ryood/LME49600_HPA_V2/P1130260.jpg

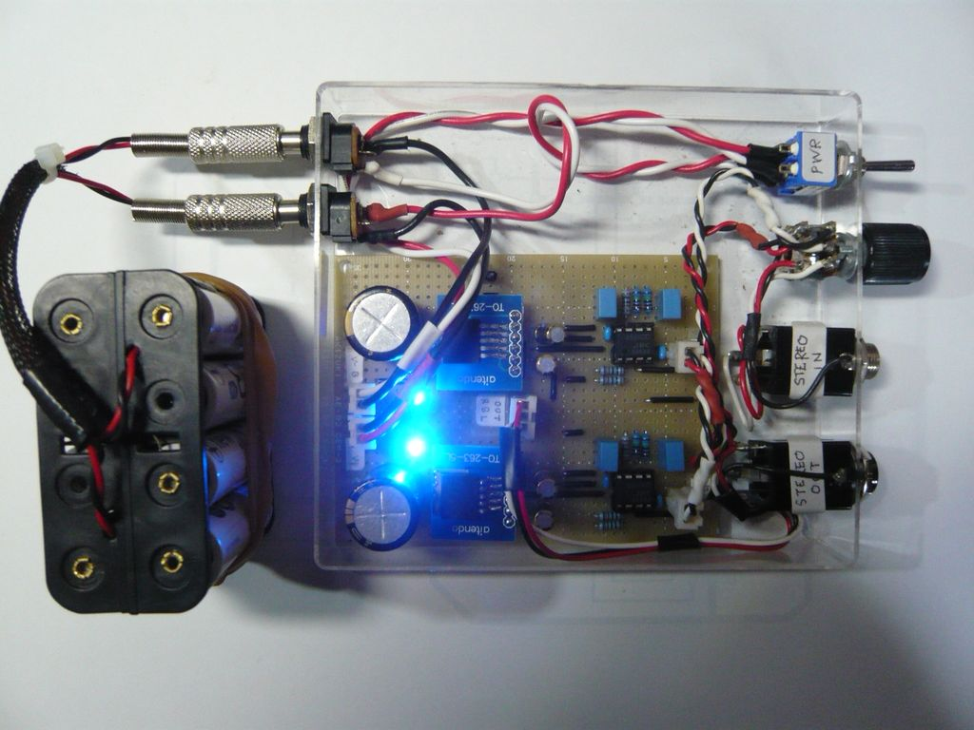
P1130260.jpg
