ryood/LME49600_HPA_V2/P1130270.jpg

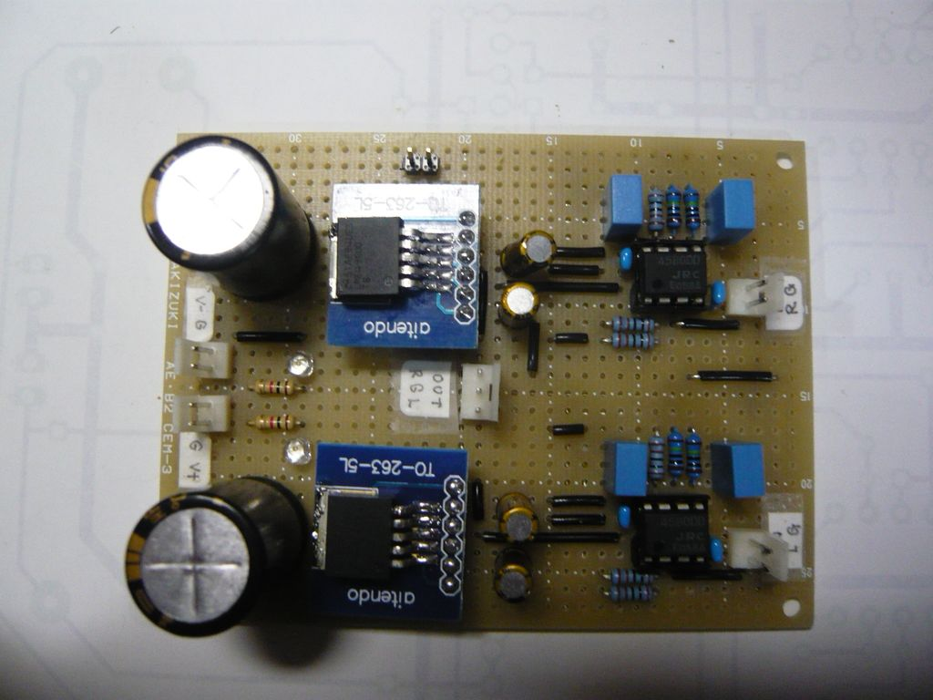
P1130270.jpg
