ryood/LME49600_HPA_V2/+-9V_PSU/7809.png

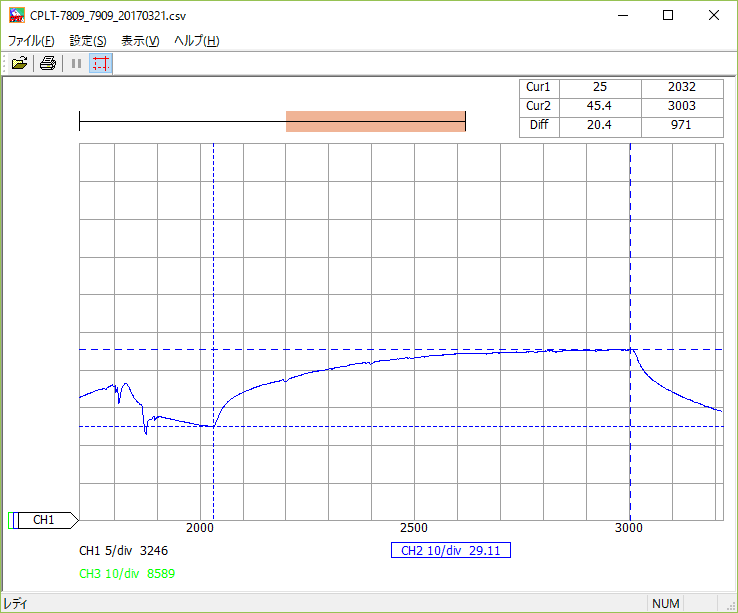
+-9V_PSU/7809.png
