ryood/LME49600_HPA_V2/+-9V_PSU/case/±9V PSU ケース内配線_ブレッドボード.png

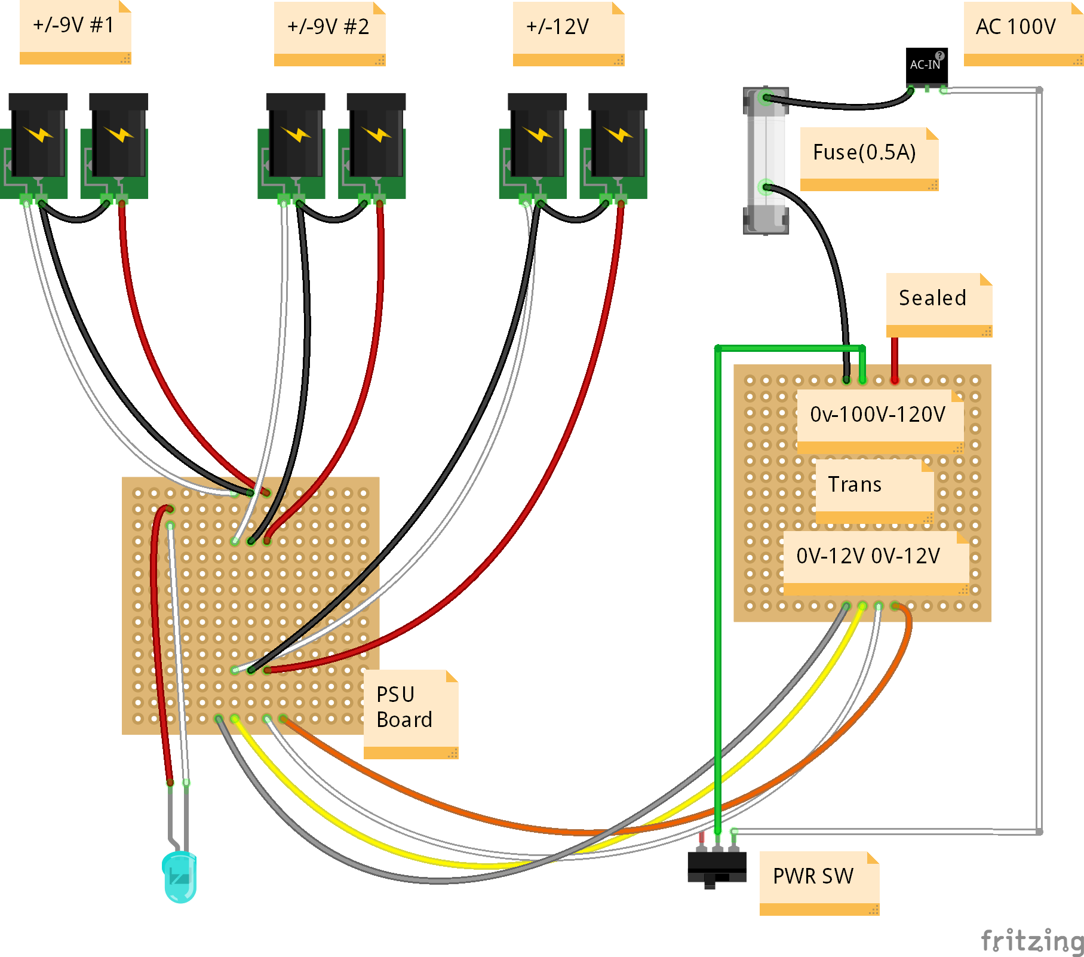
+-9V_PSU/case/±9V PSU ケース内配線_ブレッドボード.png
