ryood/LME49600_HPA_V2/+-9V_PSU/eagle/+-9V_PSU_brd.png

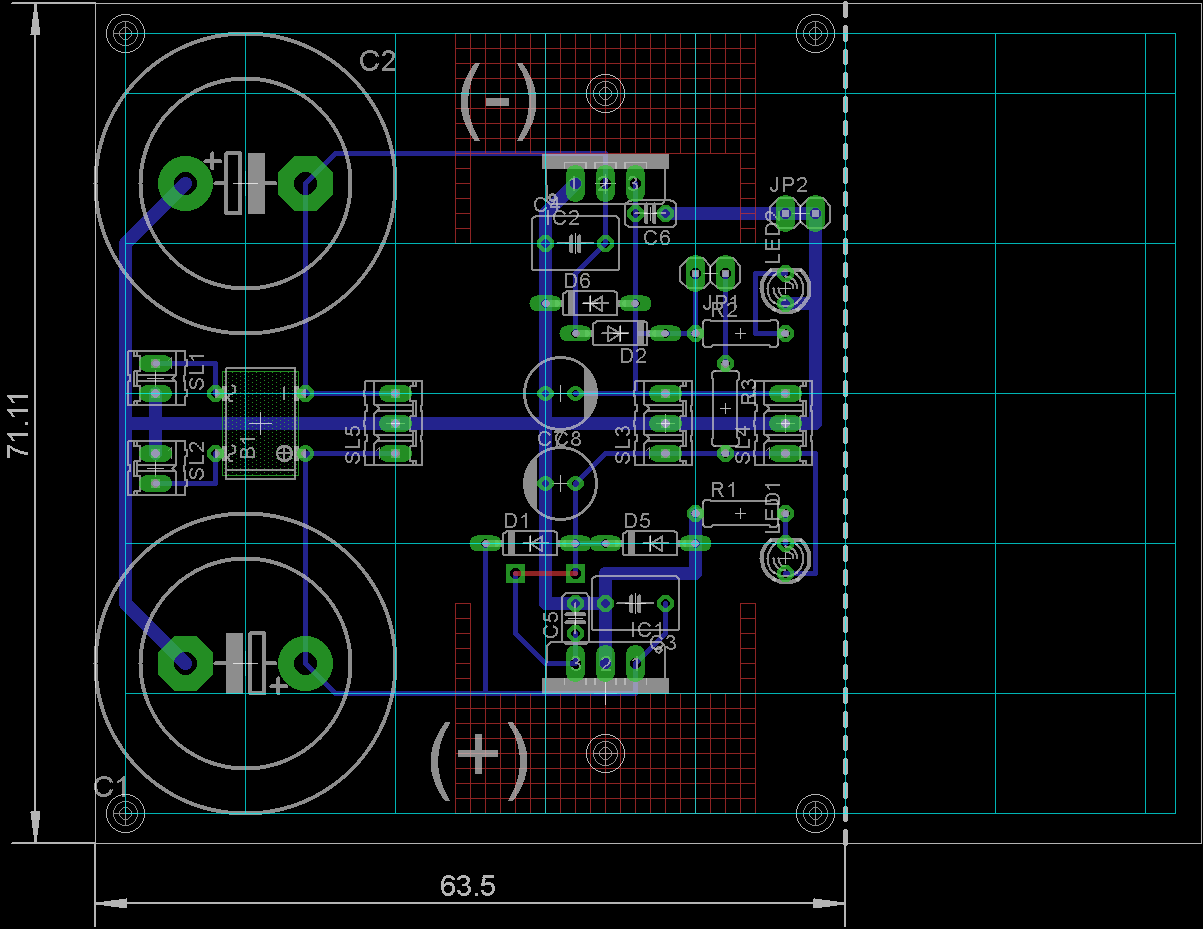
+-9V_PSU/eagle/+-9V_PSU_brd.png
