ryood/LME49600_HPA_V2/+-9V_PSU/fritzing/±9V_PSU_ブレッドボード.png

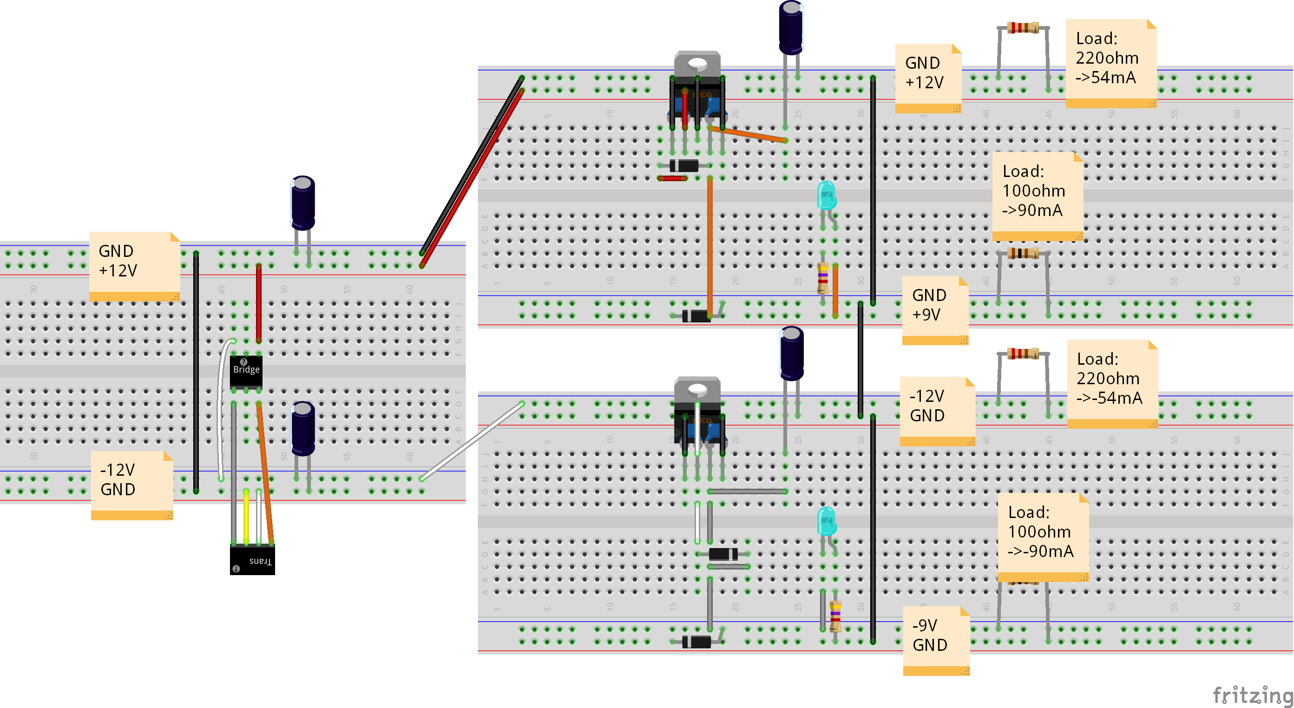
+-9V_PSU/fritzing/±9V_PSU_ブレッドボード.png
