ryood/LME49600_HPA_V2/+-9V_PSU/LTSpice/TroidalTrans_sim.png

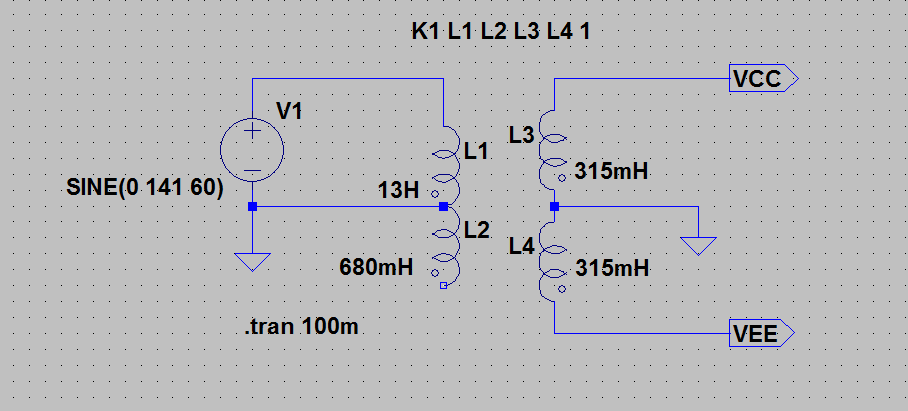
+-9V_PSU/LTSpice/TroidalTrans_sim.png
