ryood/LME49600_HPA_V2/eagle/LME49600 HPA_brd.png

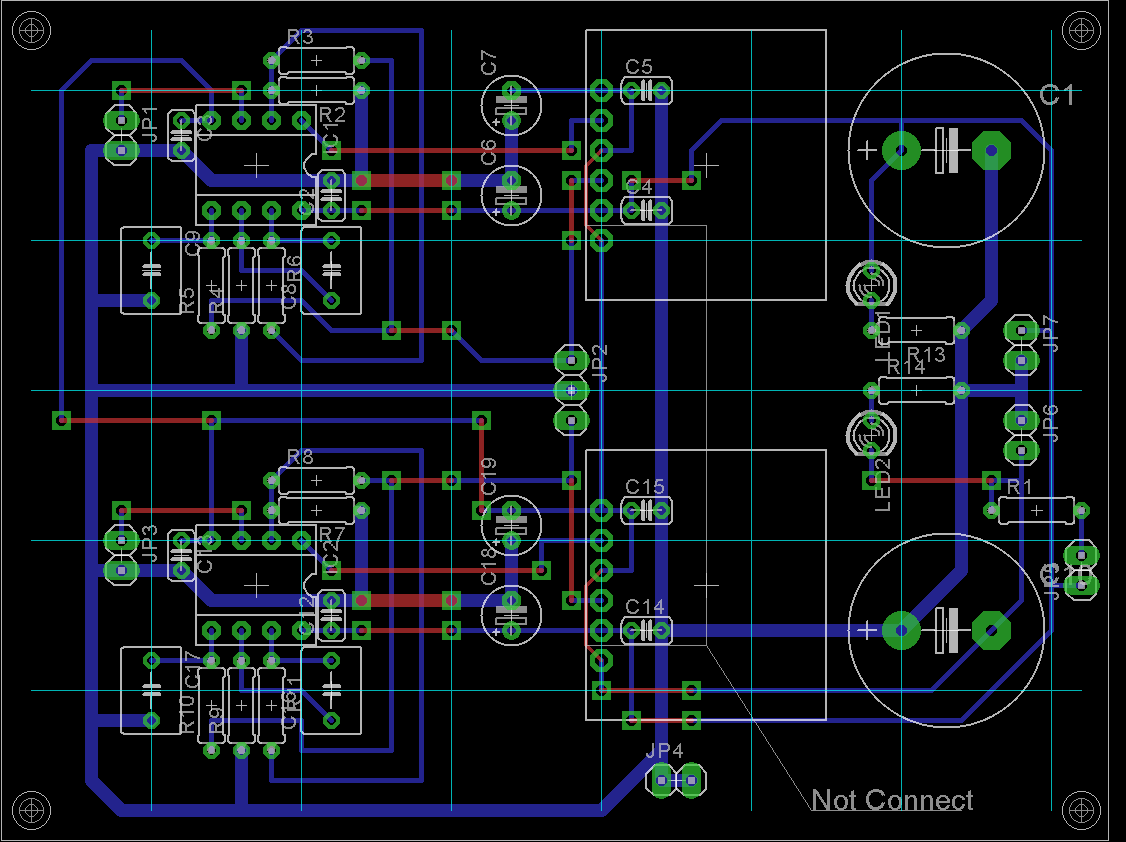
eagle/LME49600 HPA_brd.png
