ryood/LME49600_HPA_V2/eagle/LME49600 HPA_sch.png

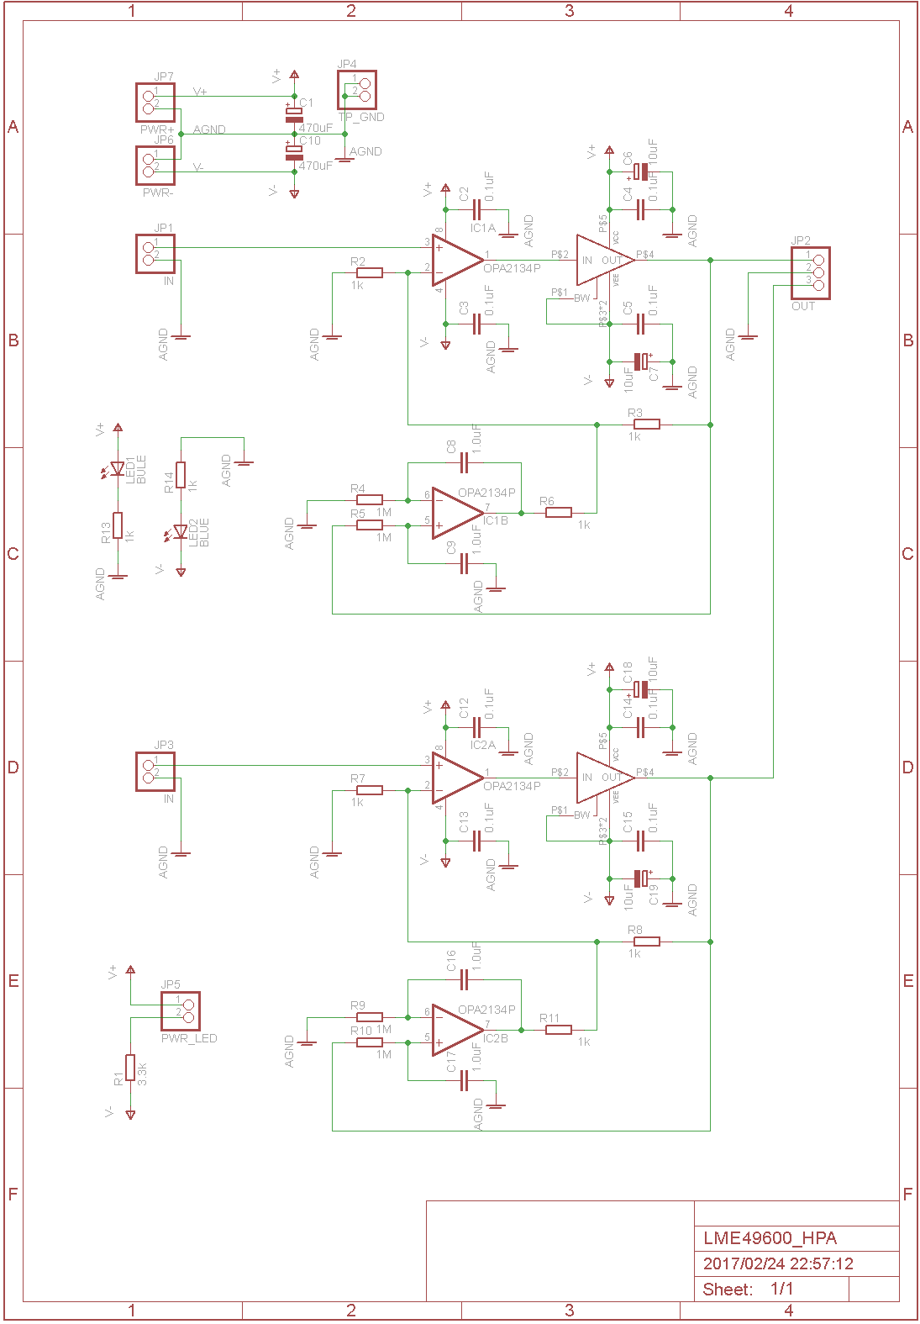
eagle/LME49600 HPA_sch.png
