ryood/LME49600_HPA_V2/fritzing/LME49600 HPA AC Coupling_ブレッドボード.png

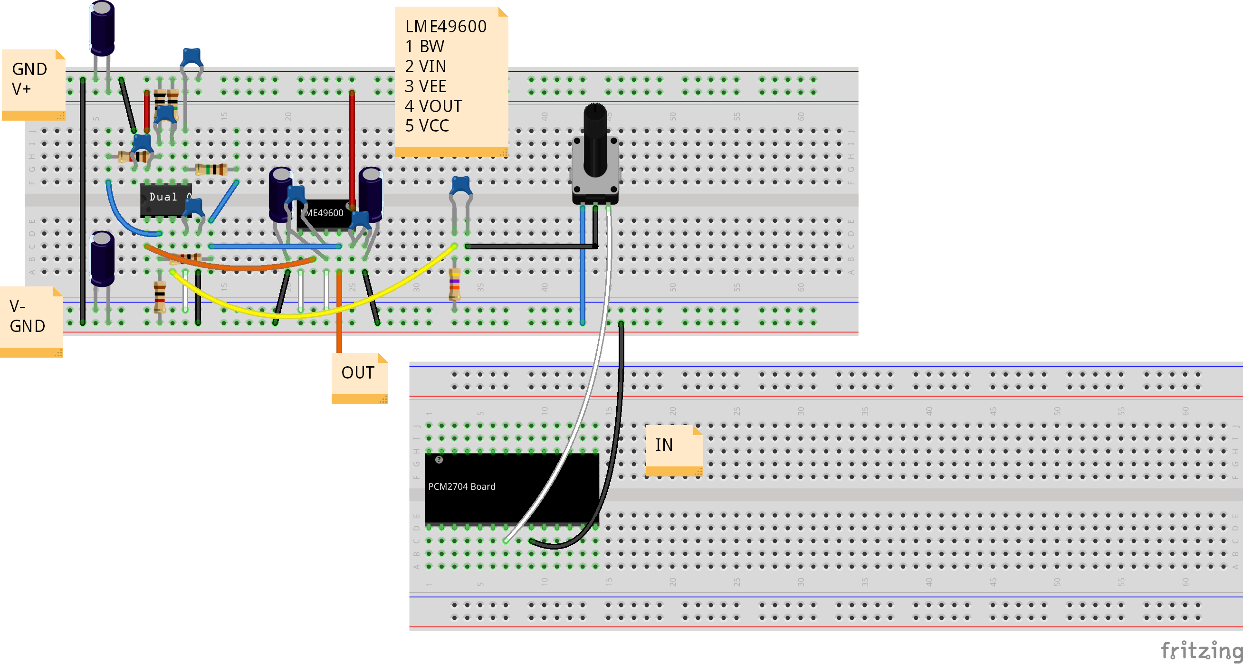
fritzing/LME49600 HPA AC Coupling_ブレッドボード.png
