ryood/LME49600_HPA_V2/LME49600_DATASHEET_HPA.png

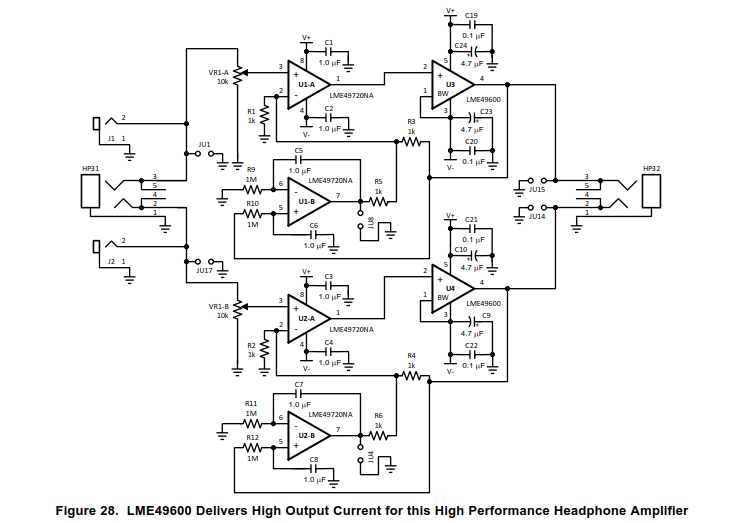
LME49600_DATASHEET_HPA.png
