ryood/LME49600_HPA_V2/LME49600_HPA_V2 特性/20170208_163742.png

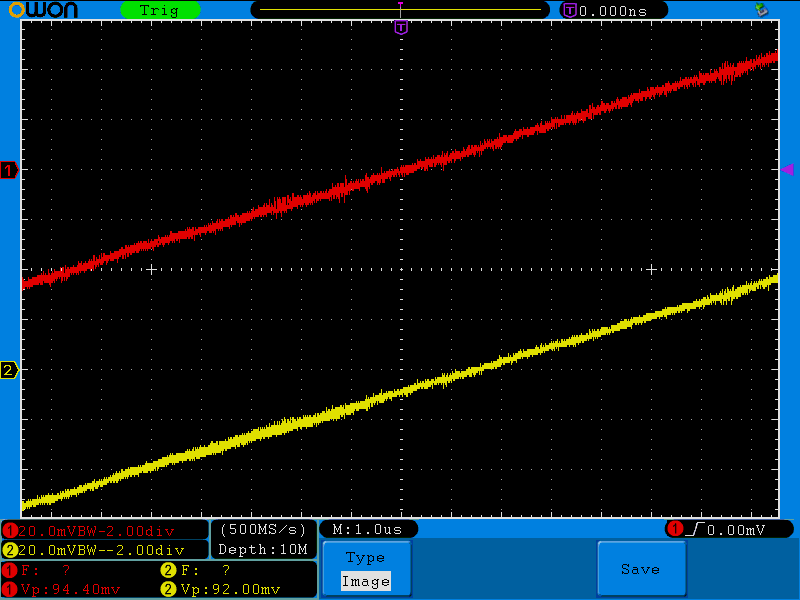
LME49600_HPA_V2 特性/20170208_163742.png
