ryood/LME49600_HPA_V2/LME49600_HPA_V2 特性/FFT_LoopBack.png

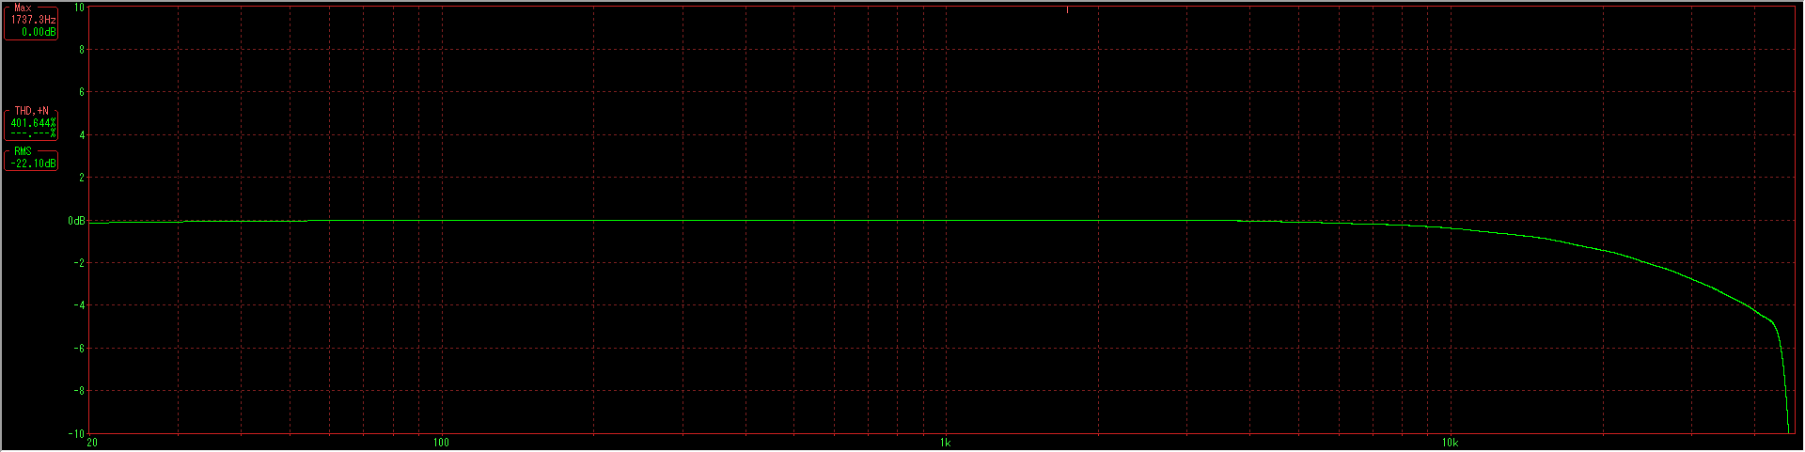
LME49600_HPA_V2 特性/FFT_LoopBack.png
