ryood/LME49600_HPA_V2/LME49600_HPA_V2 特性/LoopBack_-30dB.png

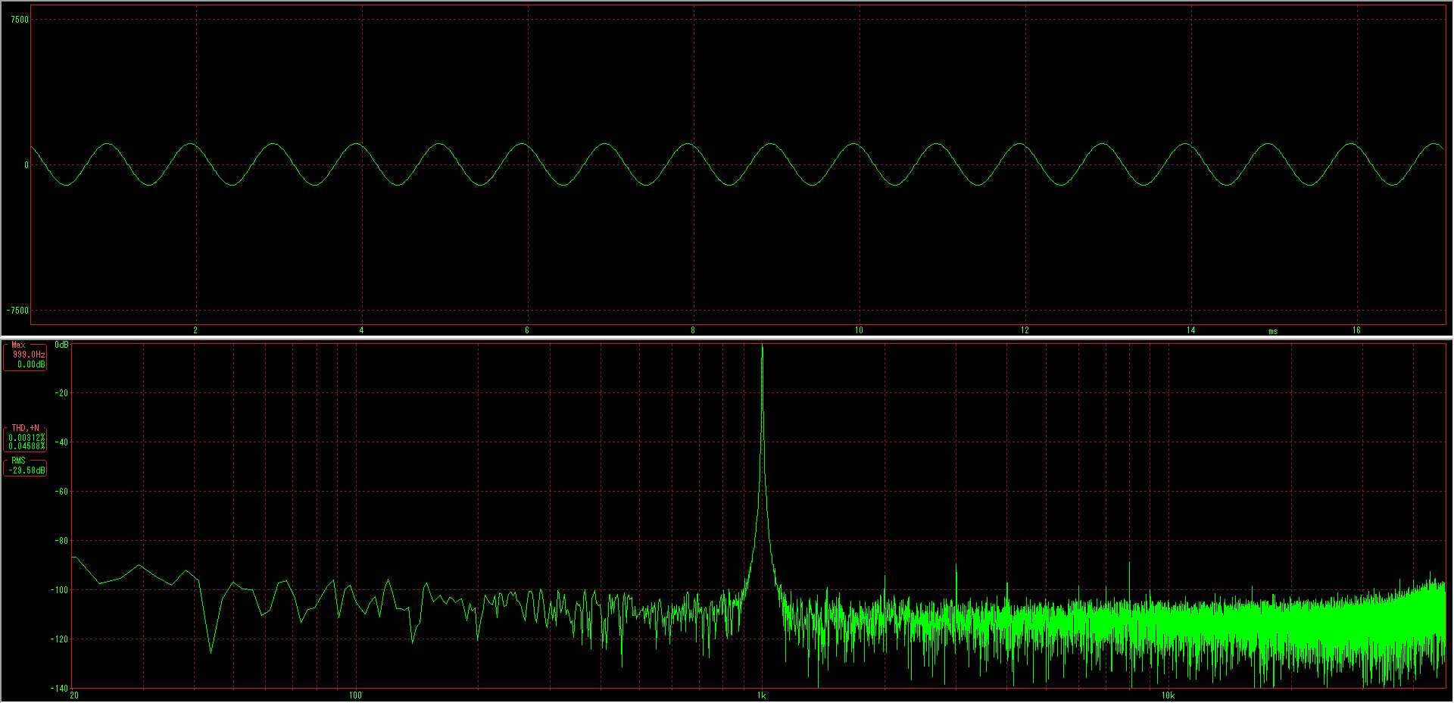
LME49600_HPA_V2 特性/LoopBack_-30dB.png
