ryood/LME49600_HPA_V2/spice/AC_coupupling_ac.png

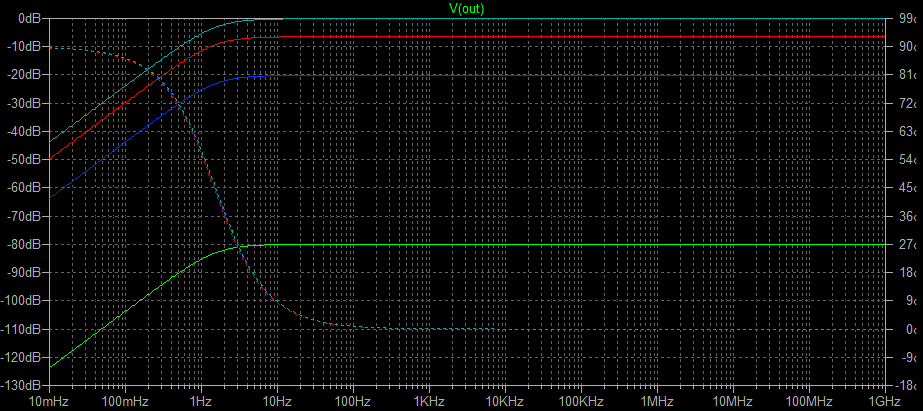
spice/AC_coupupling_ac.png
