ryood/LME49600_HPA_V2/spice/AC_coupupling_sim.png

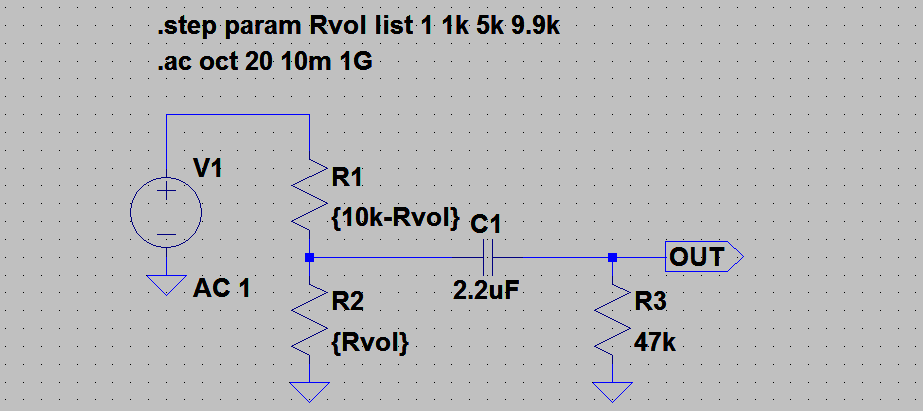
spice/AC_coupupling_sim.png
