ryood/LME49600_HPA_V2/spice/LME49600 HPA _brd.png

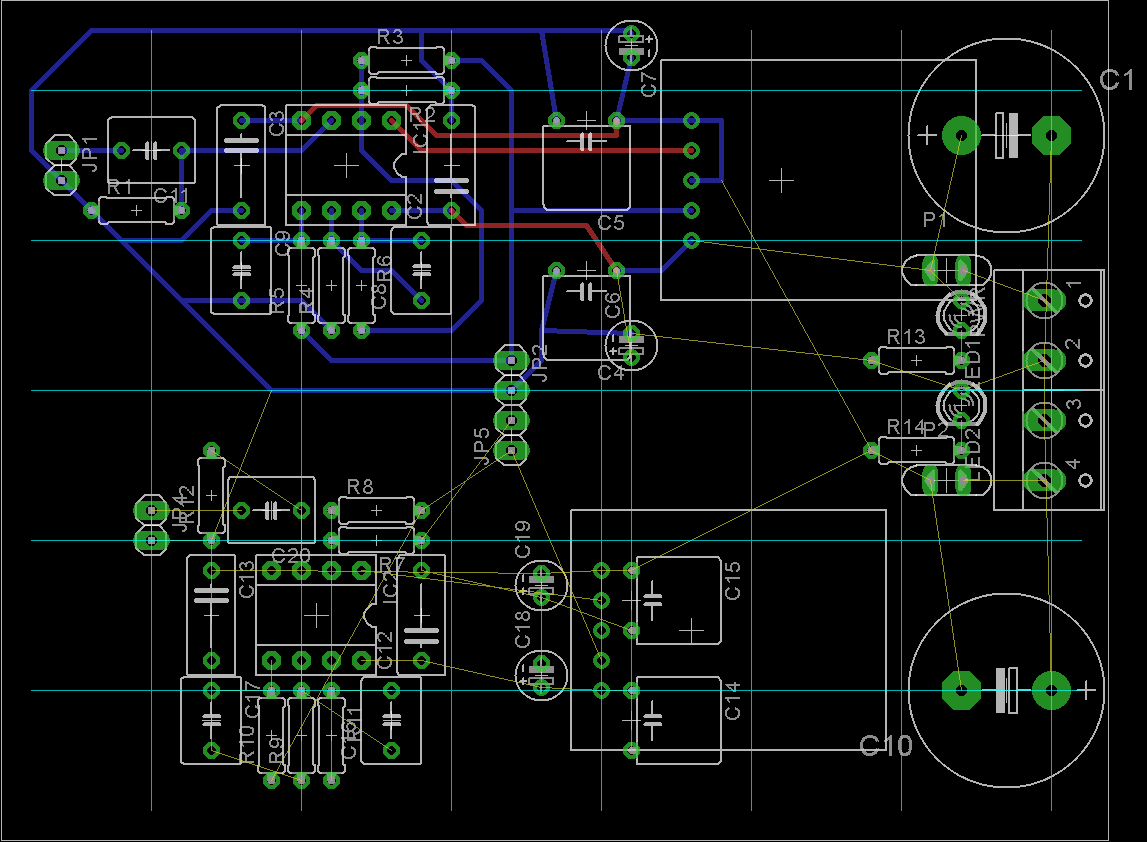
spice/LME49600 HPA _brd.png
