ryood/LME49600_HPA_V2/spice/LME49600 HPA _sch.png

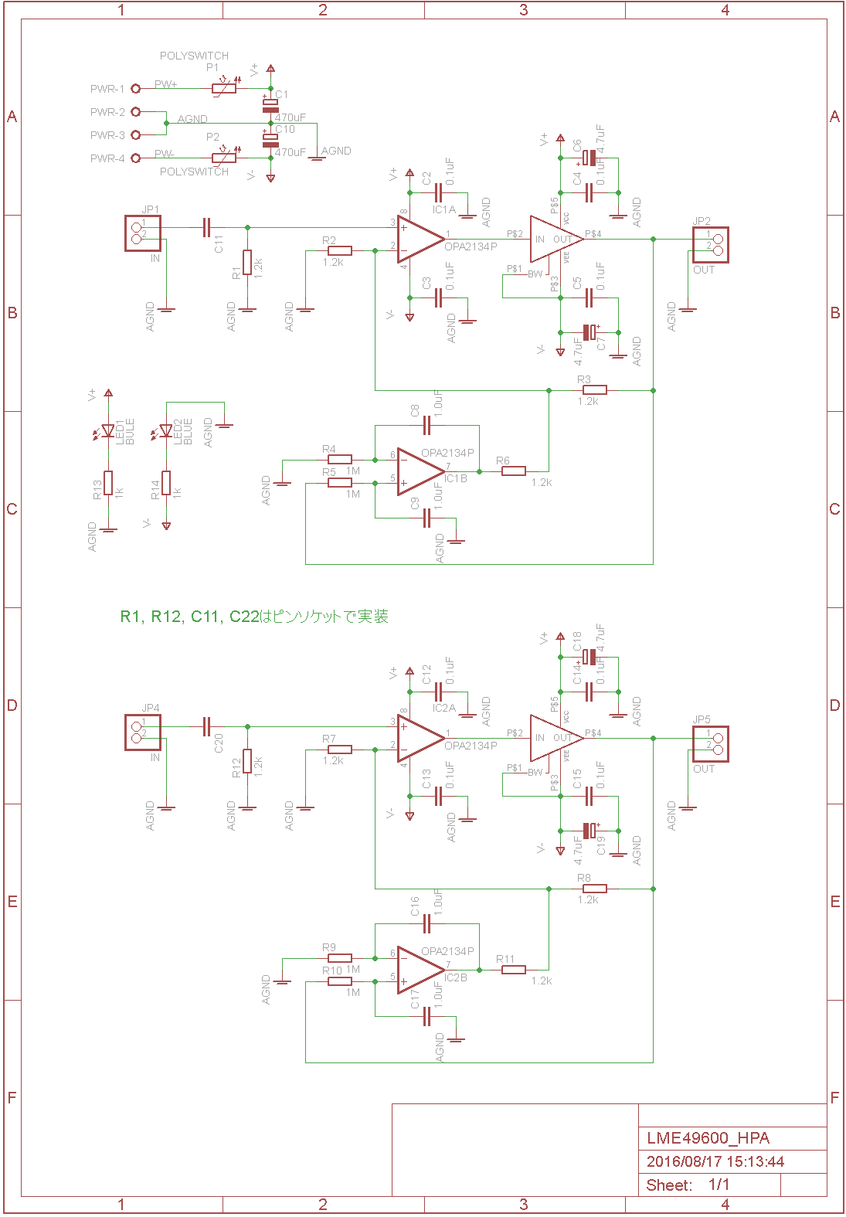
spice/LME49600 HPA _sch.png
