ryood/LME49600_HPA_V2/spice/LME49600 HPA opamp only sim.png

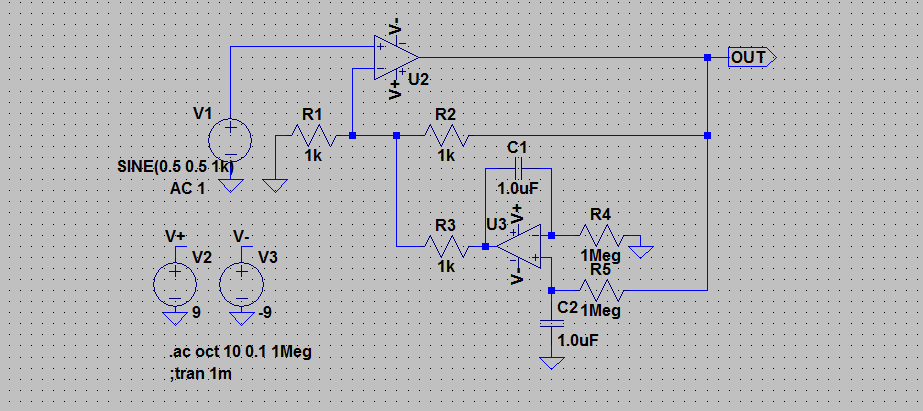
spice/LME49600 HPA opamp only sim.png
