ryood/LME49600_HPA_V2/spice/LME49600_HPA__OPA2134_ac.png

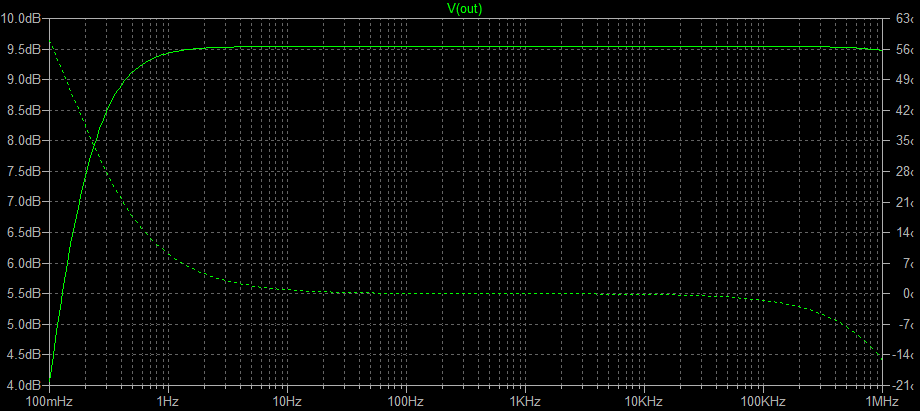
spice/LME49600_HPA__OPA2134_ac.png
