ryood/LME49600_HPA_V2/spice/LME49600_HPA_no_servo_ac.png

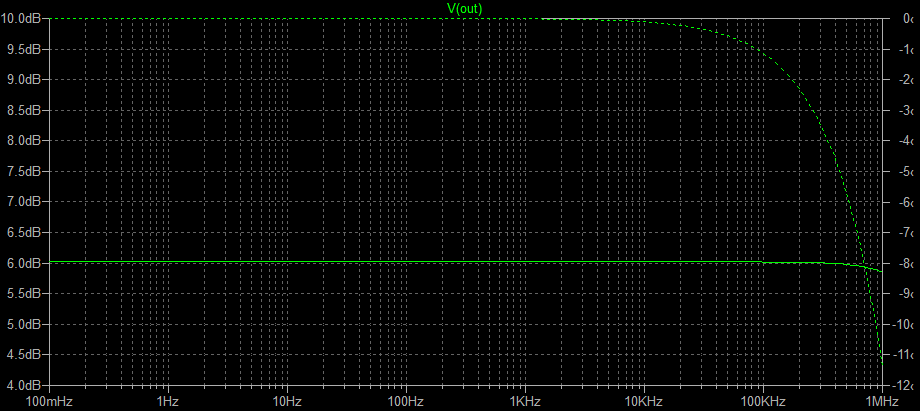
spice/LME49600_HPA_no_servo_ac.png
