ryood/LME49600_HPA_V2/spice/LME49600_HPA_sim2.png

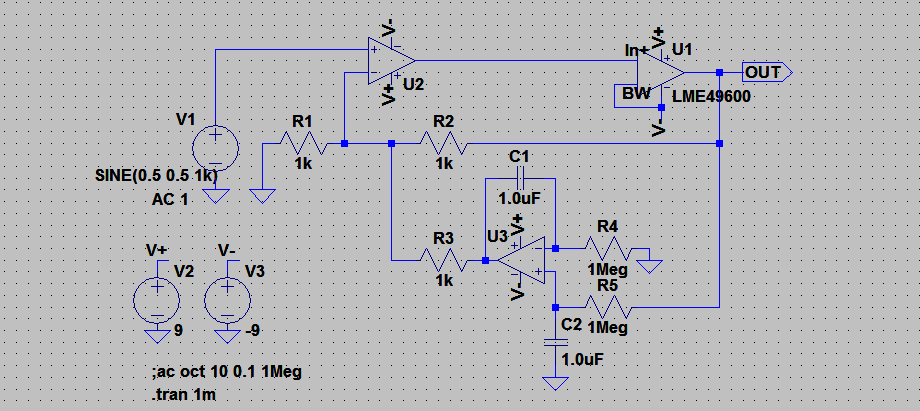
spice/LME49600_HPA_sim2.png
