ryood/LME49600_HPA_V2/spice/LME49600_HPA_tran.png

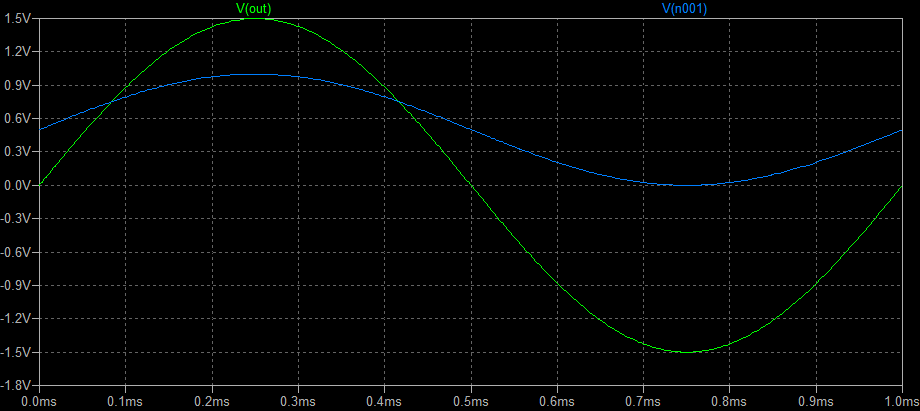
spice/LME49600_HPA_tran.png
