ryood/LME49600_HPA_V2/spice/LME49600_sim.png

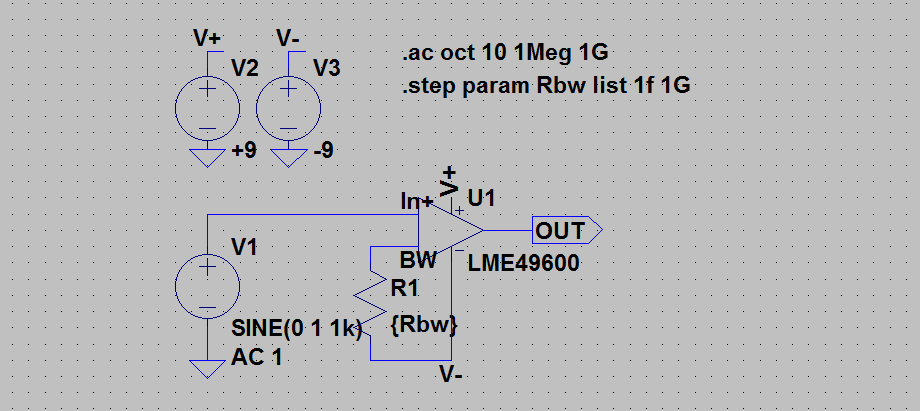
spice/LME49600_sim.png
