ryood/LME49600_HPA_V2/(list of files, cad)

Other CAD files:
+-9V_PSU/case/+-9V_PSU_YM-200.dwg
case/LME49600 PC Case.dwg
