ryood/LME49600_HPA_V2/spice/Step_OPA2134.png

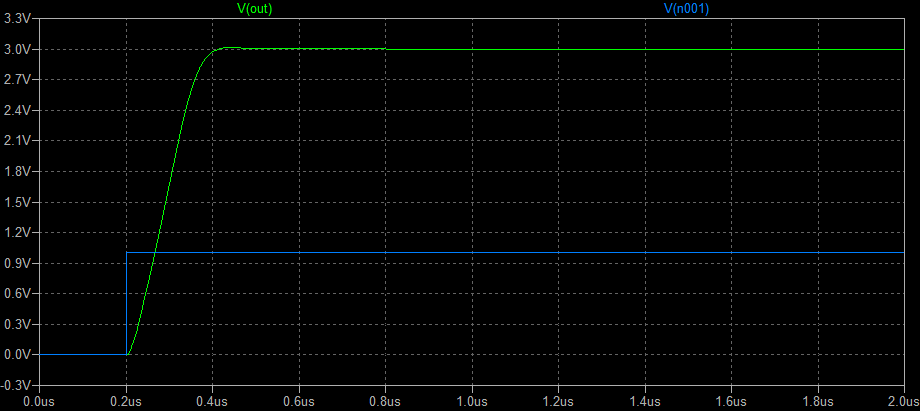
spice/Step_OPA2134.png
