ryood/LME49600_HPA_V2/fritzing/LME49600 HPA Test  OPAMP only_ブレッドボード.png

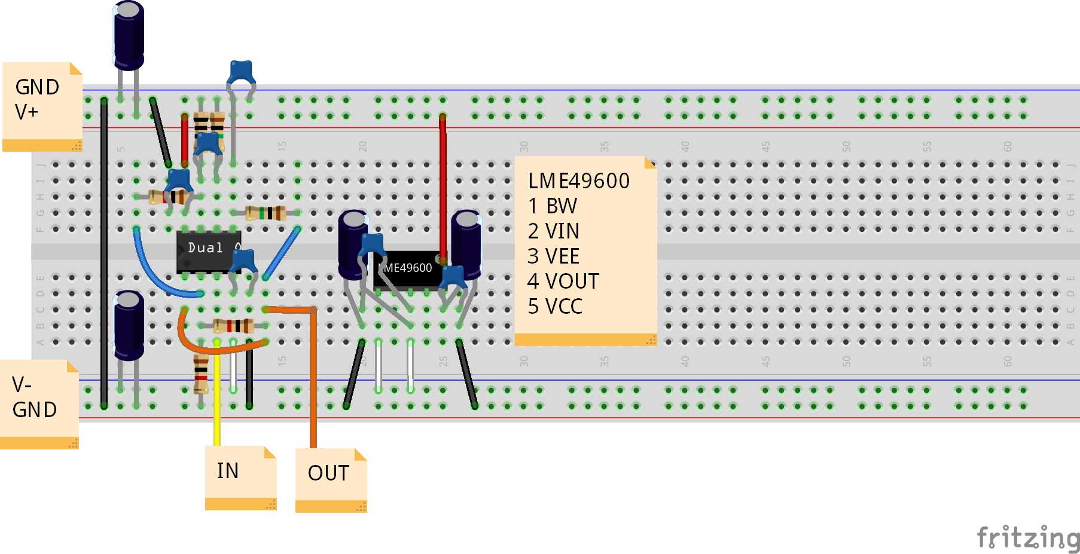
fritzing/LME49600 HPA Test OPAMP only_ブレッドボード.png
