ryood/LME49600_HPA_V2/fritzing/LME49600 HPA Test_ブレッドボード2.png

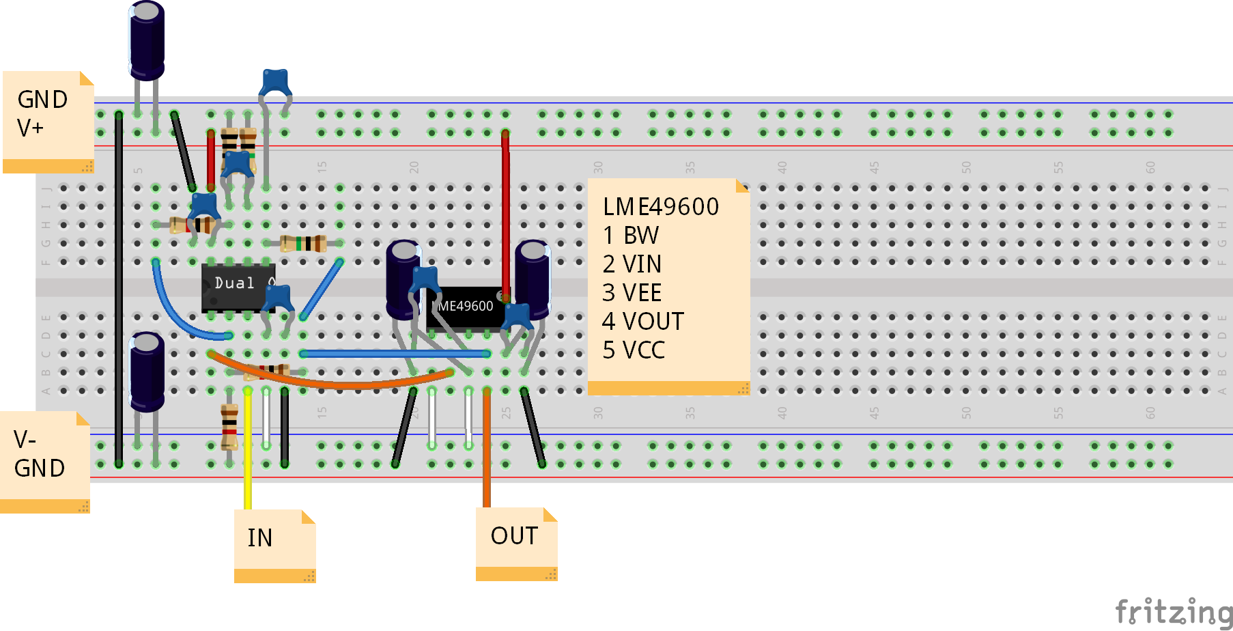
fritzing/LME49600 HPA Test_ブレッドボード2.png
