ryood/LME49600_HPA_V2/spice/OPAMP_Servo_Step_Responce.asc

C1: cap; 1.0uF
C2: cap; 1.0uF
R1: res; 1k
R2: res; 1k
R3: res; 1k
R4: res; 1Meg
R5: res; 1Meg
U1: LME49600
U2: opamp2; OPA2134
U3: opamp2; OPA2134
V1: voltage; PULSE(0 1 0 1f 1f 0.5m 1m); AC 1
V2: voltage; 9
V3: voltage; -9
Named nets: 0, V+, V-, OUT, Vin
;ac oct 10 0.1 1Meg
.tran 2us
.lib mylib\\OPA2134.LIB
