ryood/LME49600_HPA_V2/LME49600_PSU/Headphone Amp input AC coupling.asc

C1: cap; 2.2uF
R1: res; {10k-Rvol}
R2: res; {Rvol}
R3: res; 47k
V1: voltage; ""; AC 1
Named nets: 0, OUT
.ac oct 20 10m 1G
.step param Rvol list 1 1k 5k 9.9k
