ryood/LME49600_HPA_V2/LME49600_PSU/RailSplitterノイズ取り.asc

B1: bv; V=v(V1)+v(V2)
C1: cap; 0.1uF
C2: cap; 100uF
C3: cap; 10uF
C4: cap; 100uF
C5: cap; 470uF
C6: cap; 0.1uF
D1: diode
D2: diode
Q1: npn
Q2: pnp
R1: res; 4.7k
R2: res; 4.7k
R3: res; 22
R4: res; 22
R5: res; 10
R6: res; 10
U1: LT1086-12
V1: voltage; PULSE(14.9 15.1 0ms 1ms 0ms 0ms 1ms)
V2: voltage; PULSE(-0.5 +0.5 0ms 0ms 0ms 20us 40us)
Named nets: 0, V1, V2, VIN, OUT, VGND
.tran 10ms
