ryood/LME49600_HPA_V2/spice/LME49600.asc

R1: res; {Rbw}
U1: LME49600
V1: voltage; SINE(0 1 1k); AC 1
V2: voltage; +9
V3: voltage; -9
Named nets: 0, V+, V-, OUT
.ac oct 10 1Meg 1G
.step param Rbw list 1f 1G
