ryood/LME49600_HPA_V2/spice/LME49600_HPA_Servo.asc

C1: cap; 1.0uF
C2: cap; 1.0uF
R1: res; 1k
R3: res; 1k
R4: res; 1Meg
R5: res; 1Meg
U3: UniversalOpamp2
V1: voltage; PULSE(0 1 0 1 0 0 1); AC 1
V2: voltage; 9
V3: voltage; -9
Named nets: 0, V+, V-, OUT
;ac oct 10 0.1 1Meg
.tran 1
