ryood/LME49600_HPA_V2/spice/OPAMP_Servo_Sourece_Follwer.asc

C1: cap; 1.0uF
C2: cap; 1.0uF
M1: nmos
R1: res; 1k
R2: res; 1k
R3: res; 1k
R4: res; 1Meg
R5: res; 1Meg
R6: res; 1k
U2: UniversalOpamp2
U3: UniversalOpamp2
V1: voltage; SINE(0.5 0.5 1k); AC 1
V2: voltage; 9
V3: voltage; -9
Named nets: 0, V+, V-, OUT
;ac oct 10 0.1 1Meg
.tran 1m
