ryood/LME49600_HPA_V2/+-9V_PSU/LTSpice/Toroidal Trans  HDB-12(L).asc

L1: ind2; 13H; Rser=2.8k
L2: ind2; 680mH; Rser=169
L3: ind2; 315mH; Rser=77
L4: ind2; 315mH; Rser=77
V1: voltage; SINE(0 141 60)
Named nets: 0, VCC, VEE
K1 L1 L2 L3 L4 1
.tran 100m
