ryood/LME49600_HPA_V2/(list of files, drawings)

Other design files:
+-9V_PSU/case/±9V PSU ケース内配線.fzz
+-9V_PSU/fritzing/±9V_PSU.fzz
fritzing/LME49600 buffer test.fzz
fritzing/LME49600 HPA AC Coupling.fzz
fritzing/LME49600 HPA Test OPAMP only.fzz
fritzing/LME49600 HPA Test.fzz
