ryood/LME49600_HPA_V2/+-9V_PSU/eagle/+-9V_PSU/+-9V_PSU.brd

## EAGLE design +-9V_PSU/eagle/+-9V_PSU/+-9V_PSU.brd (2017-03-21)

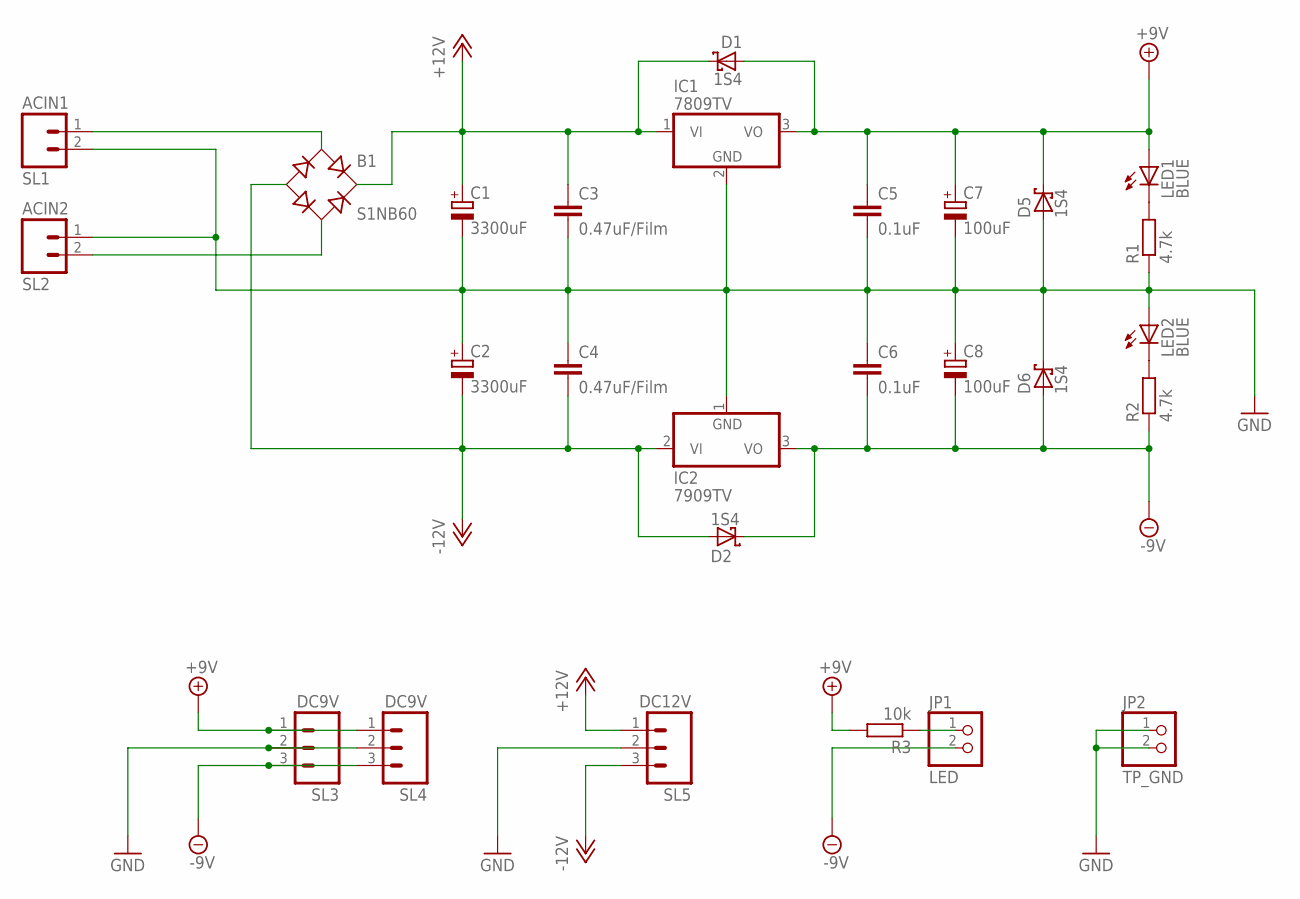
[picture p34: schematic +-9V_PSU.sch]

Parts:
B1: S1NB60; B-DIL
C1, C2: 3300uF; EB25D
C3, C4: 0.47uF/Film; C050-045X075
C5, C6: 0.1uF; C025-024X044
C7, C8: 100uF; SANYO-OSCON_C6
D1, D2, D5, D6: 1S4; DO35-7
IC1: 7809TV; TO220V
IC2: 7909TV; TO220V
JP1: LED; 1X02
JP2: TP_GND; 1X02
LED1, LED2: BLUE; LED3MM
R1, R2: 4.7k; 0207/7
R3: 10k; 0207/7
SL1: ACIN1; 02P
SL2: ACIN2; 02P
SL3, SL4: DC9V; 03P
SL5: DC12V; 03P

Connections:
+9V: C5.1, C7.+, D1.A, D5.C, IC1.3 (VO), LED1.A, R3.2, SL3.1, SL4.1
+12V: B1.+, C1.+, C3.1, D1.C, IC1.1 (VI), SL5.1
-9V: C6.2, C8.-, D2.C, D6.A, IC2.3 (VO), JP1.2, R2.1, SL3.3, SL4.3
-12V: B1.-, C2.-, C4.2, D2.A, IC2.2 (VI), SL5.3
GND: C1.-, C2.+, C3.2, C4.1, C5.2, C6.1, C7.-, C8.+, D5.A, D6.C, IC1.2 (GND), IC2.1 (GND), JP2.1, JP2.2, LED2.A, R1.1, SL1.2, SL2.1, SL3.2, SL4.2, SL5.2
unnamed: LED2.K (C), R2.2
unnamed: JP1.1, R3.1
unnamed: LED1.K (C), R1.2
unnamed: B1.AC1, SL1.1
unnamed: B1.AC2, SL2.2

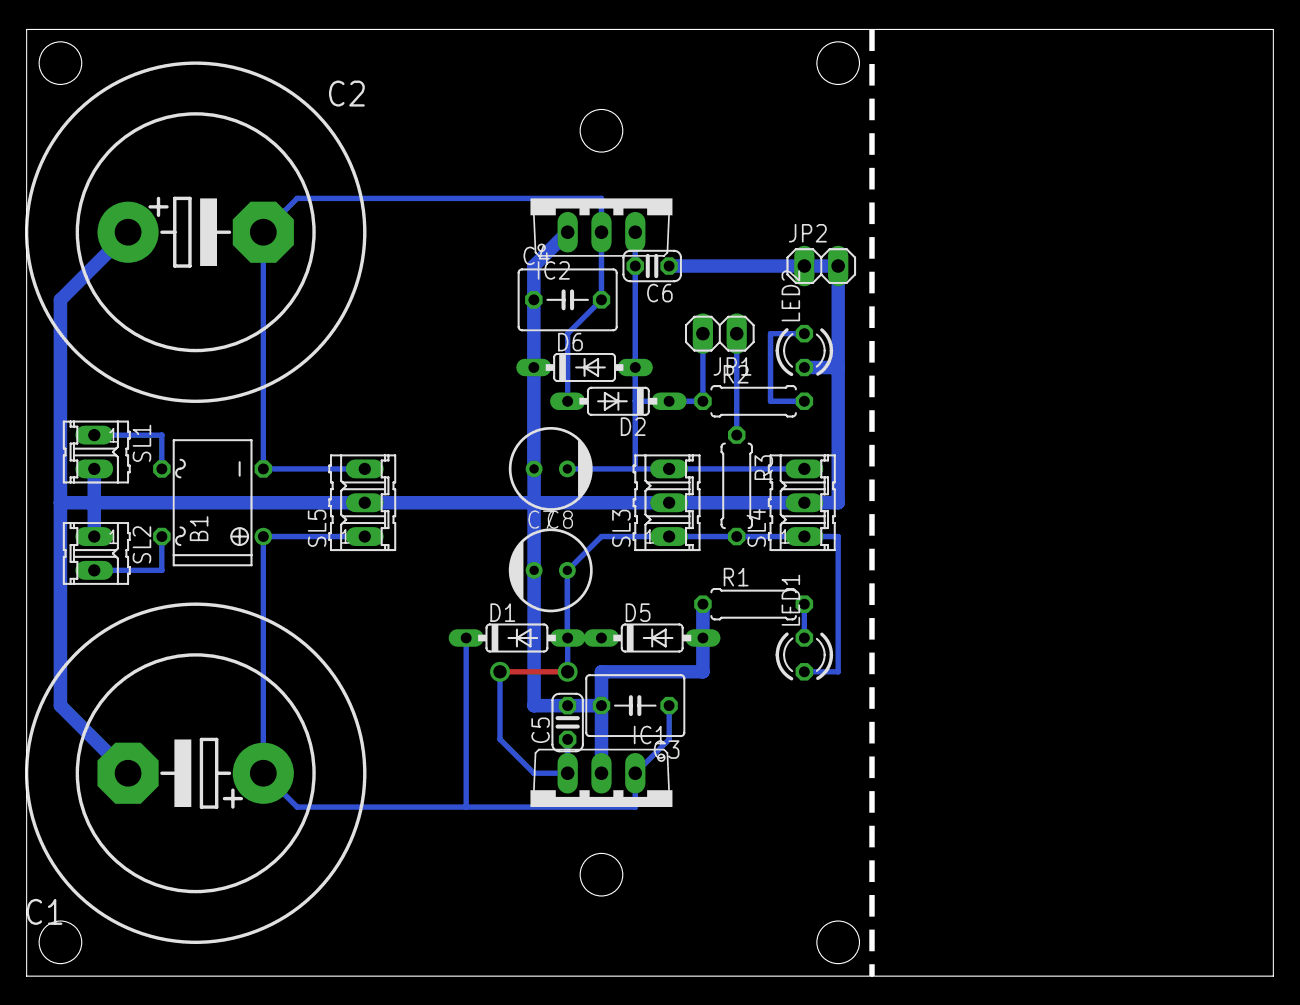
[picture p35: board +-9V_PSU.brd from above]

Board: 2 copper layers, 93.7 x 71.1 mm, 27 parts (0 on the bottom side), 10 nets.
