ryood/LME49600_HPA_V2/eagle/LME49600_HPA.brd

## EAGLE design eagle/LME49600_HPA.brd (2017-02-24)

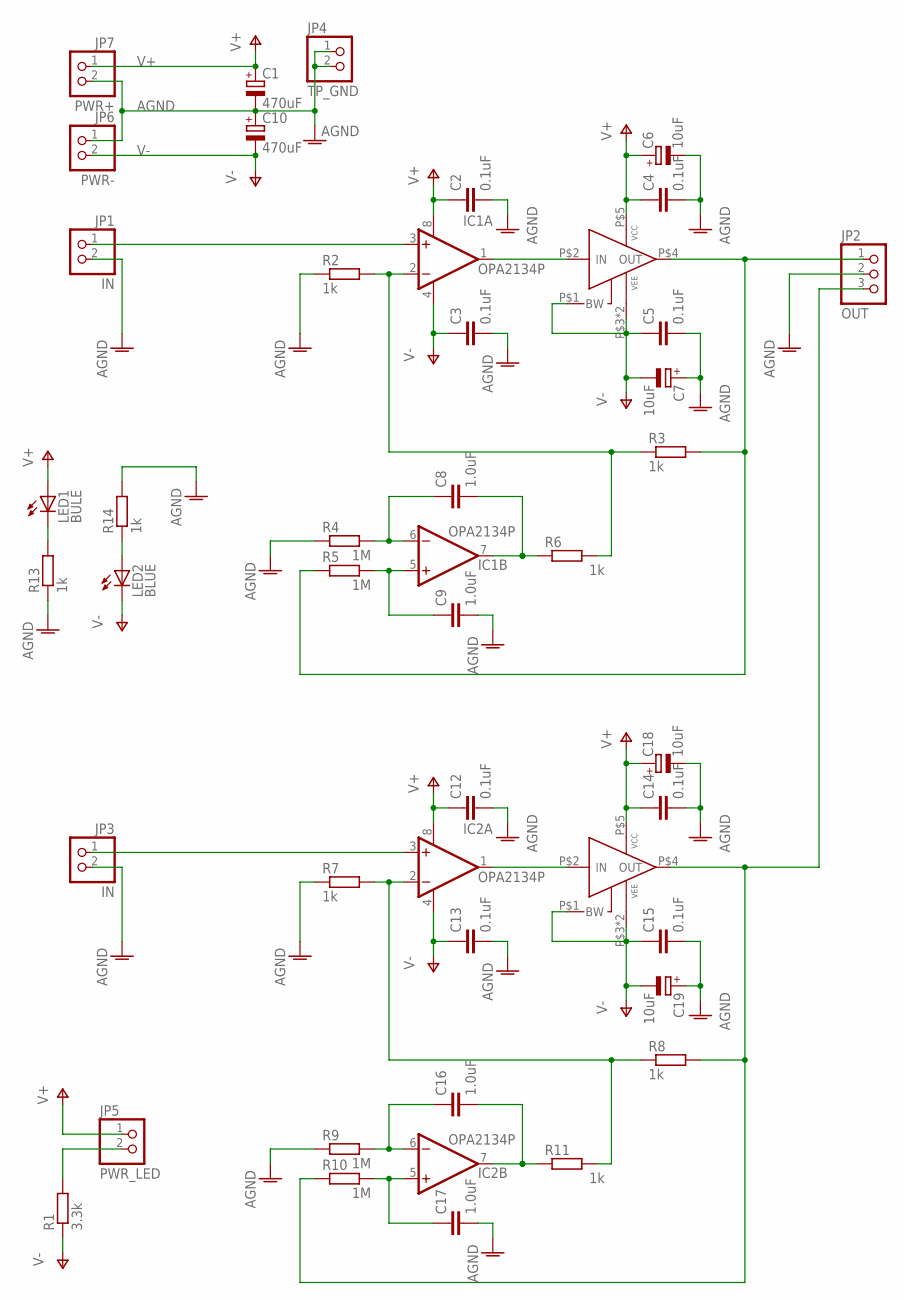
[picture p36: schematic LME49600_HPA.sch]

Parts:
C1, C10: 470uF; E7,5-16
C2, C3, C4, C5, C12, C13, C14, C15: 0.1uF; C025-024X044
C6, C7, C18, C19: 10uF; E2,5-5
C8, C9, C16, C17: 1.0uF; C050-050X075
IC1, IC2: OPA2134P; DIL08
JP1, JP3: IN; 1X02
JP2: OUT; 1X03
JP4: TP_GND; 1X02
JP5: PWR_LED; 1X02
JP6: PWR-; 1X02
JP7: PWR+; 1X02
LED1: BULE; LED3MM
LED2: BLUE; LED3MM
R1: 3.3k; 0207/7
R2, R3, R6, R7, R8, R11, R13, R14: 1k; 0207/7
R4, R5, R9, R10: 1M; 0207/7
U$1, U$2: LME49600-BRD3; TO-263-5L

Connections:
AGND: C1.-, C2.2, C3.2, C4.2, C5.2, C6.-, C7.+, C9.2, C10.+, C12.2, C13.2, C14.2, C15.2, C17.2, C18.-, C19.+, JP1.2, JP2.2, JP3.2, JP4.1, JP4.2, JP6.1, JP7.2, R2.1, R4.1, R7.1, R9.1, R13.1, R14.2
unnamed: IC1.3 (+IN), JP1.1
unnamed: LED2.A, R14.1
unnamed: IC1.2 (-IN), R2.2, R3.1, R6.2
unnamed: IC2.2 (-IN), R7.2, R8.1, R11.2
unnamed: IC2.1 (OUT), U$2.P$2 (IN)
unnamed: C8.1, IC1.6 (-IN), R4.2
unnamed: IC1.1 (OUT), U$1.P$2 (IN)
unnamed: C9.1, IC1.5 (+IN), R5.2
unnamed: C16.1, IC2.6 (-IN), R9.2
unnamed: C17.1, IC2.5 (+IN), R10.2
unnamed: C8.2, IC1.7 (OUT), R6.1
unnamed: C16.2, IC2.7 (OUT), R11.1
unnamed: JP2.3, R8.2, R10.1, U$2.P$4 (OUT)
unnamed: JP2.1, R3.2, R5.1, U$1.P$4 (OUT)
unnamed: IC2.3 (+IN), JP3.1
unnamed: JP5.2, R1.2
unnamed: LED1.K (C), R13.2
V+: C1.+, C2.1, C4.1, C6.+, C12.1, C14.1, C18.+, IC1.8 (V+), IC2.8 (V+), JP5.1, JP7.1, LED1.A, U$1.P$5 (VCC), U$2.P$5 (VCC)
V-: C3.1, C5.1, C7.-, C10.-, C13.1, C15.1, C19.-, IC1.4 (V-), IC2.4 (V-), JP6.2, LED2.K (C), R1.1, U$1.P$1 (BW), U$1.P$3 (VEE), U$1.P$6 (VEE), U$2.P$1 (BW), U$2.P$3 (VEE), U$2.P$6 (VEE)

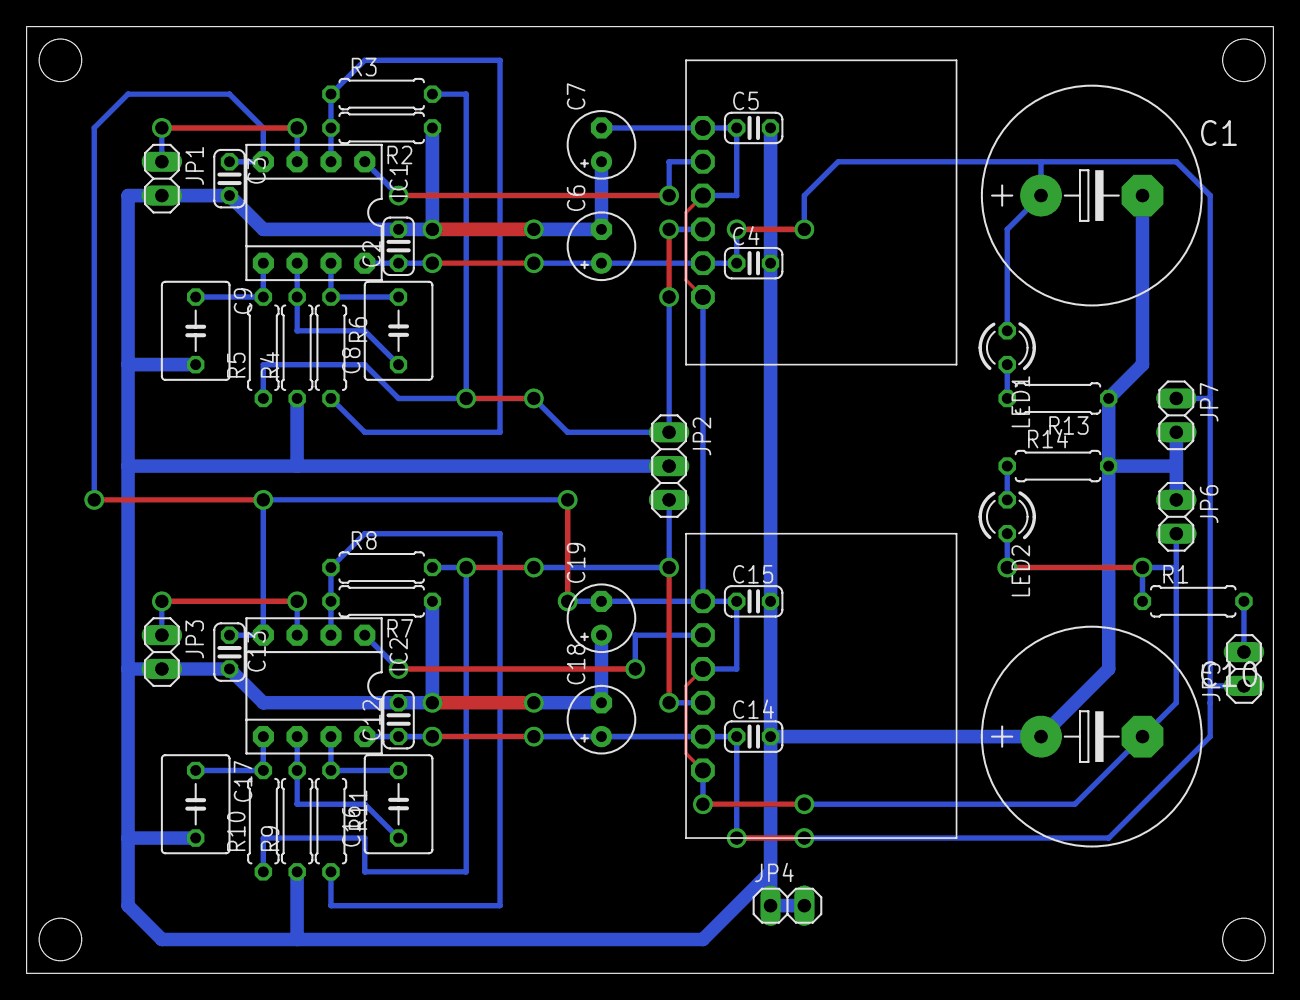
[picture p37: board LME49600_HPA.brd from above]

Board: 2 copper layers, 93.7 x 71.1 mm, 44 parts (0 on the bottom side), 20 nets.
