ryood/LME49600_HPA_V2/(commit log)

2017-01-30 Update: the board design (tantal->Alminium)
    [LME49600_HPA.brd]
2017-02-02 Update: Eagle files
    [LME49600_HPA.brd, LME49600_HPA.sch]
2017-02-08 Updated: テスト表
    [LME49600 HPA テスト表 20160831.xlsx, LME49600 HPA テスト表 2017.02.04.xlsx]
2017-02-08 Eagle Files: Add TP-GND
    [LME49600_HPA.brd, LME49600_HPA.sch]
2017-02-24 Add: PWR LED
    [LME49600_HPA.brd, LME49600_HPA.sch]
2017-03-10 Add: +-9V_PSU
    [+-9V_PSU.brd, +-9V_PSU.sch, 7808_20170310.csv, 7809_20170310.csv, ±9V_PSU.fzz]
2017-03-10 +-9V PSU Board design
    [+-9V_PSU.brd, +-9V_PSU.sch]
2017-03-10 +-9V_PSU Update
    [+-9V_PSU.brd]
2017-03-10 Schematic & Board Image
2017-03-21 Add: +/-9V PSU Case
    [+-9V_PSU.brd, +-9V_PSU_YM-200.dwg, 7809_20170315.csv, 7909_20170315.csv, ±9V PSU ケース内配線.fzz, ±9V PSU テスト表.xlsx]
2017-03-24 Update: Case designe
    [+-9V_PSU_YM-200.dwg, 7809_7909_20170321.csv]
